jamesshao8/ymfc-mini-drone/README.md

# ymfc-mini-drone
mini-drone (hardware design and software modification), based on ymfc-32

For detailed info, please visit:
https://www.crowdsupply.com/shaos-gadget/ymfc-flight-controller-and-mini-drone
