jamesshao8/ymfc-mini-drone/hardware/BOM_mini_drone_cs_2021-04-14.csv

ID | Name | Designator | Footprint | Quantity | Manufacturer Part | Manufacturer | Supplier | Supplier Part | Price | LCSC Assembly
1 | 100nF | C1,C2,C3,C4,C5,C6,C15,C17,C18,C19,C20,C21,C22,C23,C24,C27 | C0603 | 16 | CC0603KRX7R9BB104 | YAGEO | LCSC | C14663 | 0.01875 | Yes
2 | 22pF | C13,C14 | C0603 | 2 | CL10C220JB8NNNC | SAMSUNG | LCSC | C1653 | 0.032714 | Yes
3 | 2.2nF | C16 | C0603 | 1 | 0603B222K500NT | FH | LCSC | C1604 | 0.029075 | Yes
4 | 22uF | C25,C26 | C0805 | 2 | CL21A226MAQNNNE | SAMSUNG | LCSC | C45783 | 0.192553 | Yes
5 | SS210 | D1 | SMA_L4.3-W2.6-LS5.2-RD | 1 | SS210 | MDD | LCSC | C14996 | 0.128505 | Yes
6 | HDR-M-2.54_1x2 | BAT,J1,LF,LR,RF,RR | HDR-M-2.54_1X2 | 6 |  |  | LCSC | C124375 | 0.14
7 | 19-217/BHC-ZL1M2RY/3T | LEDB | LED0603-R-RD | 1 | 19-217/BHC-ZL1M2RY/3T | EVERLIGHT | LCSC | C72041 | 0.088419 | Yes
8 | 19-217/GHC-YR1S2/3T | LEDG | LED0603-R-RD | 1 | 19-217/GHC-YR1S2/3T | EVERLIGHT | LCSC | C72043 | 0.142772 | Yes
9 | LSSAM12-V-T/R | OFF/ON | SW-SMD_LSSAM12-V-T/R | 1 | LSSAM12-V-T/R | Diptronics | LCSC | C495944 | 1.7
10 | HDR-M-2.54_1x3 | PPM,PWM1,PWM2,PWM3,PWM4 | HDR-M-2.54_1X3 | 5 |  |  | LCSC | C180248 | 1.15
11 | SI2302 | Q1,Q2,Q3,Q4 | SOT-23-3_L2.9-W1.3-P1.90-LS2.4-BR | 4 | SI2302 | Hottech | LCSC | C181087 | 0.137 | Yes
12 | 4.7K | R1,R2,R5,R6 | R0603 | 4 | 0603WAF4701T5E | UniOhm | LCSC | C23162 | 0.005826 | Yes
13 | 100 | R3,R4 | R0402 | 2 | 0402WGF1000TCE | UniOhm | LCSC | C25076 | 0.003333 | Yes
14 | 1K | R7,R10,R12,R13,R16 | R0402 | 5 | 0402WGF1001TCE | UniOhm | LCSC | C11702 | 0.004793 | Yes
15 | 10K | R8,R9,R11,R14,R15 | R0402 | 5 | 0402WGF1002TCE | UniOhm | LCSC | C25744 | 0.004183 | Yes
16 | TS-1187A-B-A-B | RST | SW-SMD_4P-L5.1-W5.1-P3.70-LS6.4 | 1 | TS-1187A-B-A-B | XKB Enterprise | LCSC | C318884 | 0.138421 | Yes
17 | HDR-M-2.54_1x4 | SER | HDR-M-2.54_1X4 | 1 |  |  | LCSC | C124378 | 0.143949
18 | STM32F103C8T6 | U1 | LQFP-48_L7.0-W7.0-P0.50-LS9.0-BL | 1 | STM32F103C8T6 | STMicroelectronics | LCSC | C8734 | 14.18 | Yes
19 | MPU-6050_C24112 | U2 | QFN-24_L4.0-W4.0-P0.50-BL-EP2.6 | 1 | MPU-6050 | InvenSense | LCSC | C24112 | 15.69 | Yes
20 | HT7533-1_C14289 | U3 | SOT-89-3_L4.5-W2.5-P1.50-LS4.2-BR | 1 | HT7533-1 | HOLTEK | LCSC | C14289 | 0.77914 | Yes
21 | 8MHz | X1 | OSC-SMD_L5.0-W3.2 | 1 | X50328MSB2GI | YXC | LCSC | C115962 | 1.58 | Yes
