jamesshao8/ymfc-mini-drone/(threads)

Thread 1 (2021-05-19):

Q&A

jamesshao8, 2021-05-19:
Hello backers,

Thanks for supporting this campaign. Should you have any question or difficulty in assembling the mini-drone, please leave a comment here. I will answer your questions so that other backers can take it as a reference.

KavinduZoysa, 2023-07-16:
Hello, What is the size of brushed DC motors used for mini drone?

KavinduZoysa, 2023-07-16:
> Hello, What is the size of brushed DC motors used for mini drone?

In the video, I found it as 8520. I just want to confirm it.

jamesshao8, 2023-07-17:
> > Hello, What is the size of brushed DC motors used for mini drone?
>
> In the video, I found it as 8520. I want to confirm it. Also, can you mention the size of the propellers?

Yes, the motors are 8520. Propeller is 75mm.

KavinduZoysa, 2023-07-17:
Can you provide some details of the mosfet used to control the brushed motors? I found it as `SI2302`, but there are several mosfet types that belong to this category.

jamesshao8, 2023-07-17:
> Can you provide some details of the mosfet used to control the brushed motors? I found it as `SI2302`, but there are several mosfet types that belong to this category.

I didn't use any special kind of mosfet. You can find enough information in the BOM.

FYI, I have pre-assembled product for comparison.
https://www.crowdsupply.com/shaos-gadget/ymfc-flight-controller-and-mini-drone

KavinduZoysa, 2023-07-17:
> BOM

From where can I found the BOM?

thurstinn, 2024-06-12:
I have everything setup up in both hardware and software as specified in this repo. My drone is running mini_main and when turning on the red led is eventually off indicating the setup was successful and there are no errors. Despite this when i try to throttle up the drone it immediately wants to pitch forward and/or left indicating that it is not leveling itself. Are there any pointers you can give me to help me get my drone to fly?

thurstinn, 2024-06-12:
I have verified that the propellers are correctly installed and have ran all the test code. The gyro/accelerometer are outputting data and responding to movement and the controller is functioning correctly. When the loop starts (start = 0) I am supposed to move the sticks to the top left to calibrate level correct? Also another question I have is that the code says to throttle low and yaw left to make start = to 1 and then while start = 1, throttle low and yaw right to make start = to 2 starting the motors and turning off the green led. But in practice I only move throttle low and yaw left to start the motors and the green led stays on. What am I missing and could this have anything to do with why its not working?

jamesshao8, 2024-06-12:
1. Yes, you can move both sticks to top left to calibrate level, but even if you do that, the drone will still drift a bit, because it doesn't have GPS to hold position. So it's normal that it wants to pitch forward when in the air, and you need to constantly adjust right stick.
2. throttle low, yaw left <-> start = 1. throttle low, yaw middle <-> start = 2, and motor spin. throttle low, yaw right <-> start = 0, and motor stop.
3. Yes, you won't see green led turning off in practice. Because when start becomes 2, next time entering into the loop, it will always execute green_led(HIGH) at line 200. I know it's a bit controverse with line 249, but we don't have too much LEDs to indicate different status.- The code at line 200 is trying to indicate flight mode. You can remove that, since mini-drone only have one flight mode.
4. For flight controller setting, you need set pitch (channel 2) in reverse direction as indicated in my video series. If not, the drone would go forward when you are controlling backward, and it can be found out with mini_test firmware.

jamesshao8, 2024-06-12:
> I have verified that the propellers are correctly installed and have ran all the test code. The gyro/accelerometer are outputting data and responding to movement and the controller is functioning correctly. When the loop starts (start = 0) I am supposed to move the sticks to the top left to calibrate level correct? Also another question I have is that the code says to throttle low and yaw left to make start = to 1 and then while start = 1, throttle low and yaw right to make start = to 2 starting the motors and turning off the green led. But in practice I only move throttle low and yaw left to start the motors and the green led stays on. What am I missing and could this have anything to do with why its not working? Also are there any other settings beside default that I should be applying to my remote controller ( I am using the FS-i6X)? I appreciate your help.

1. Yes, you can move both sticks to top left to calibrate level, but even if you do that, the drone will still drift a bit, because it doesn't have GPS to hold position. So it's normal that it wants to pitch forward when in the air, and you need to constantly adjust right stick.
2. throttle low, yaw left <-> start = 1. throttle low, yaw middle <-> start = 2, and motor spin. throttle low, yaw right <-> start = 0, and motor stop.
3. Yes, you won't see green led turning off in practice. Because when start becomes 2, next time entering into the loop, it will always execute green_led(HIGH) at line 200. I know it's a bit controverse with line 249, but we don't have too much LEDs to indicate different status.- The code at line 200 is trying to indicate flight mode. You can remove that, since mini-drone only have one flight mode.
4. For flight controller setting, you need set pitch (channel 2) in reverse direction as indicated in my video series. If not, the drone would go forward when you are controlling backward, and it can be found out with mini_test firmware.

thurstinn, 2024-06-13:
Thanks for your help. I found out that my gyro is rotated 90 degrees from where it is supposed to be so I just changed which side was going to be front and moved the motors accordingly and now I am having better success at getting it off the ground.
