jamesshao8/ymfc-mini-drone/hardware/Schematic_mini_drone_cs_2021-04-14.pdf

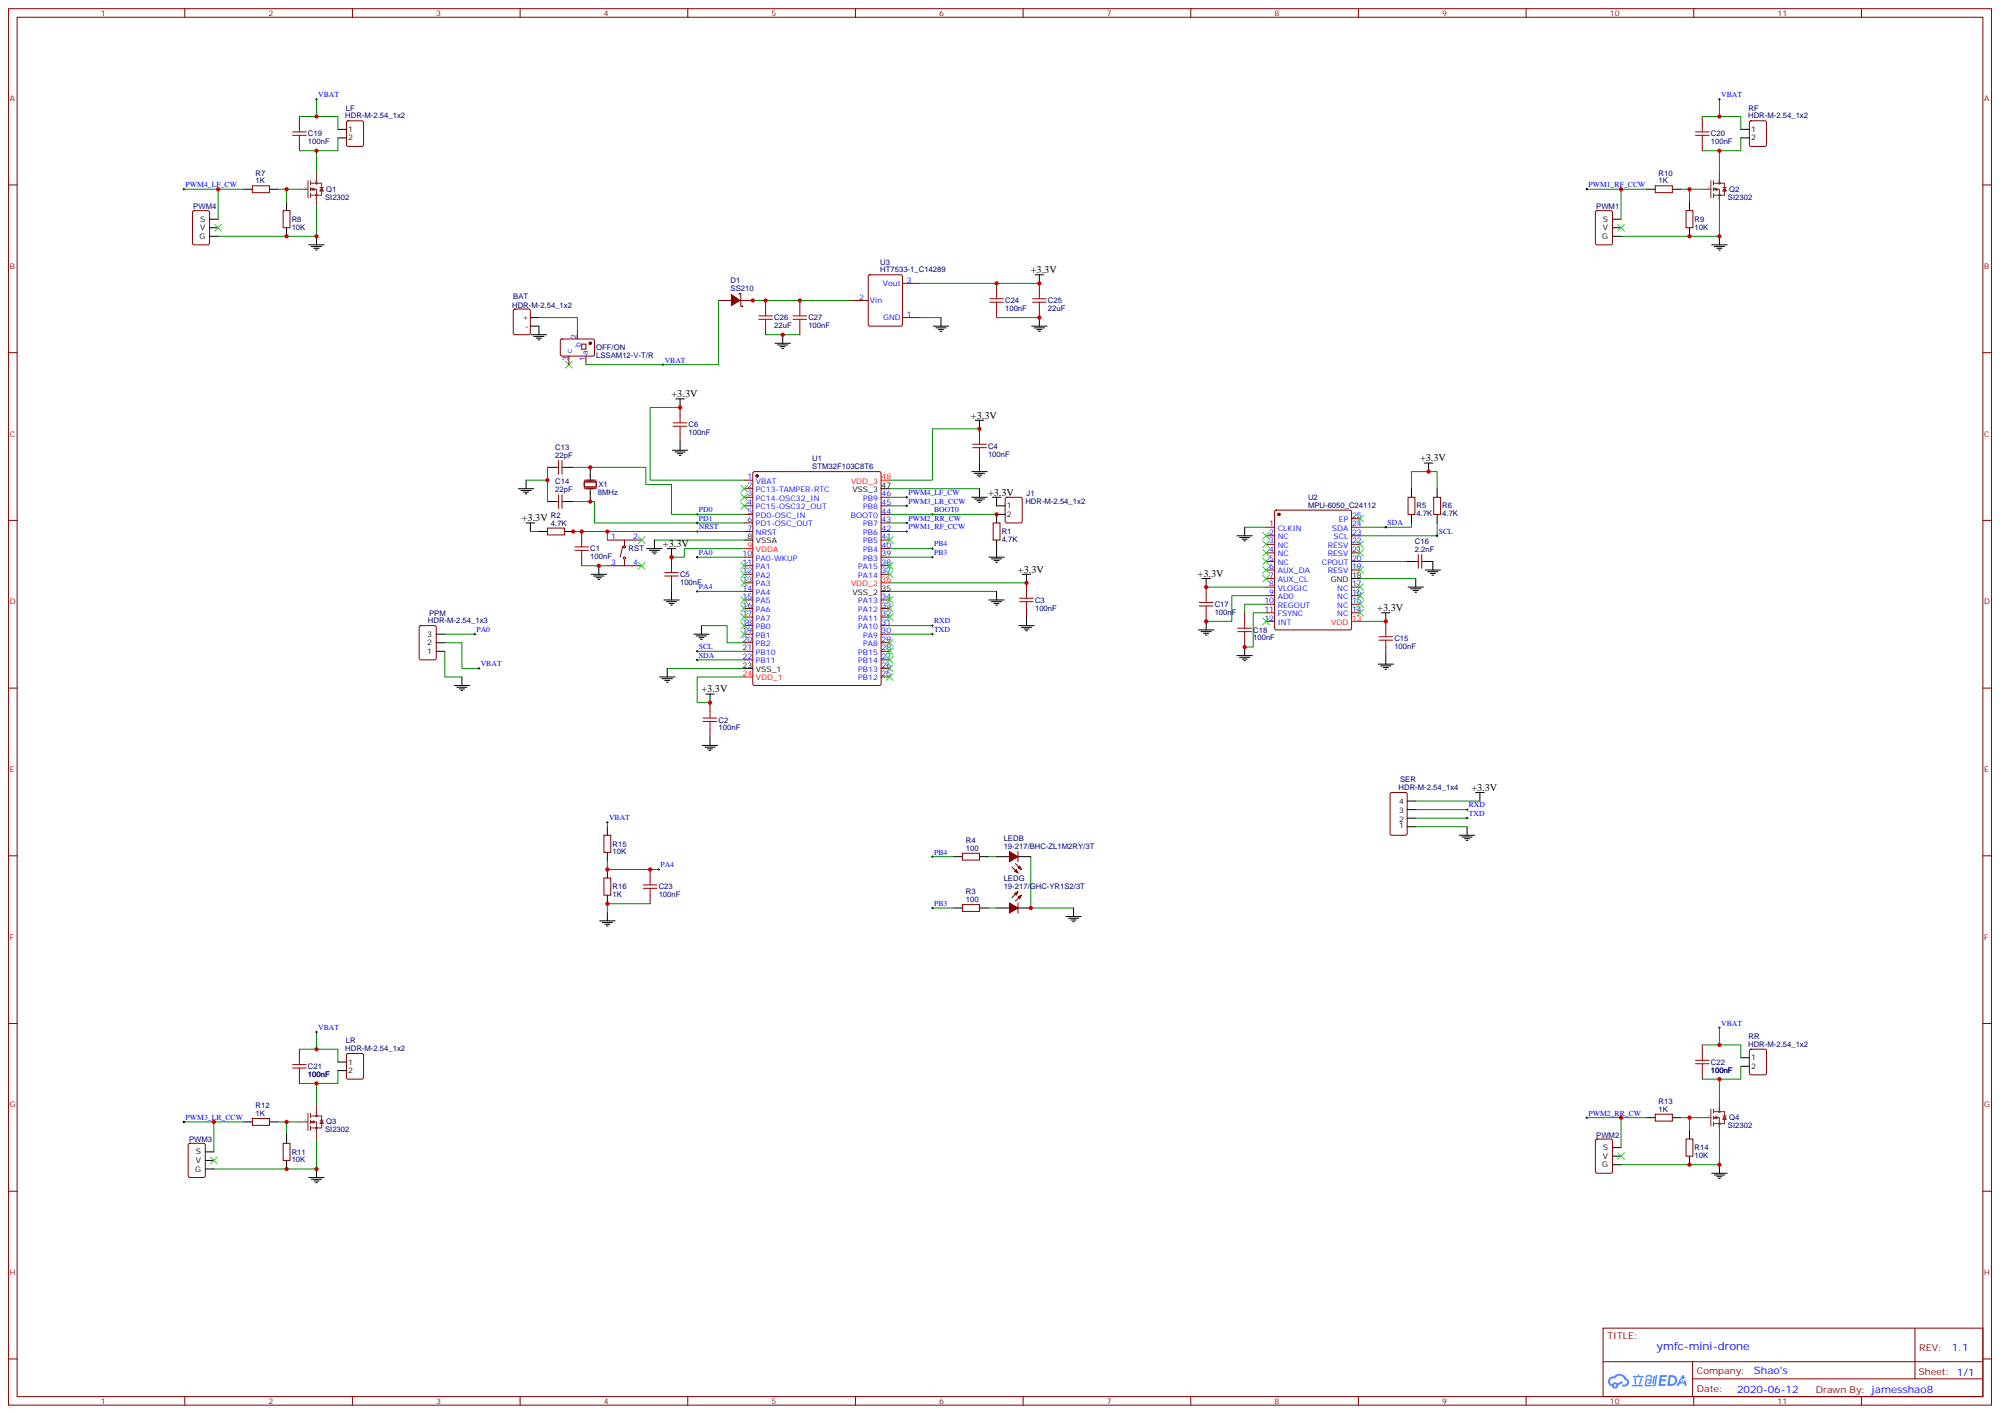
[picture p1: page 1]
