jamesshao8/ymfc-mini-drone/fc/flight_controller_main/flight_controller_main.ino

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
#include <EEPROM.h>
#include <Wire.h>                          //Include the Wire.h library so we can communicate with the gyro.
TwoWire HWire (2, I2C_FAST_MODE);          //Initiate I2C port 2 at 400kHz.

///////////////////////////////////////////////////////////////////////////////////////////////////////////////////////////////////////
//PID gain and limit settings
///////////////////////////////////////////////////////////////////////////////////////////////////////////////////////////////////////
float pid_p_gain_roll = 1.3;               //Gain setting for the pitch and roll P-controller (default = 1.3).
float pid_i_gain_roll = 0.04;              //Gain setting for the pitch and roll I-controller (default = 0.04).
float pid_d_gain_roll = 18.0;              //Gain setting for the pitch and roll D-controller (default = 18.0).
int pid_max_roll = 400;                    //Maximum output of the PID-controller (+/-).

float pid_p_gain_pitch = pid_p_gain_roll;  //Gain setting for the pitch P-controller.
float pid_i_gain_pitch = pid_i_gain_roll;  //Gain setting for the pitch I-controller.
float pid_d_gain_pitch = pid_d_gain_roll;  //Gain setting for the pitch D-controller.
int pid_max_pitch = pid_max_roll;          //Maximum output of the PID-controller (+/-).

float pid_p_gain_yaw = 4.0;                //Gain setting for the pitch P-controller (default = 4.0).
float pid_i_gain_yaw = 0.02;               //Gain setting for the pitch I-controller (default = 0.02).
float pid_d_gain_yaw = 0.0;                //Gain setting for the pitch D-controller (default = 0.0).
int pid_max_yaw = 400;                     //Maximum output of the PID-controller (+/-).

//During flight the battery voltage drops and the motors are spinning at a lower RPM. This has a negative effecct on the
//altitude hold function. With the battery_compensation variable it's possible to compensate for the battery voltage drop.
//Increase this value when the quadcopter drops due to a lower battery voltage during a non altitude hold flight.
float battery_compensation = 40.0;

int16_t manual_takeoff_throttle = 1505;    //Enter the manual hover point when auto take-off detection is not desired (between 1400 and 1600).
int16_t motor_idle_speed = 1100;           //Enter the minimum throttle pulse of the motors when they idle (between 1000 and 1200). 1170 for DJI

uint8_t gyro_address = 0x68;               //The I2C address of the MPU-6050 is 0x68 in hexadecimal form.

float battery_voltage_calibration = 0.0;   //Battery voltage offset calibration.
float low_battery_warning = 3.4;          //Set the battery warning at 10.5V (default = 10.5V).

///////////////////////////////////////////////////////////////////////////////////////////////////////////////////////////////////////
//Declaring global variables
///////////////////////////////////////////////////////////////////////////////////////////////////////////////////////////////////////
//int16_t = signed 16 bit integer
//uint16_t = unsigned 16 bit integer

uint8_t last_channel_1, last_channel_2, last_channel_3, last_channel_4;
uint8_t check_byte, flip32, start;
uint8_t error, error_counter, error_led;
uint8_t flight_mode, flight_mode_counter, flight_mode_led;
uint8_t takeoff_detected, manual_altitude_change;
uint8_t channel_select_counter;
uint8_t level_calibration_on;

int16_t esc_1, esc_2, esc_3, esc_4;
int16_t manual_throttle;
int16_t throttle, takeoff_throttle, cal_int;
int16_t temperature, count_var;
int16_t acc_x, acc_y, acc_z;
int16_t gyro_pitch, gyro_roll, gyro_yaw;

int32_t channel_1_start, channel_1;
int32_t channel_2_start, channel_2;
int32_t channel_3_start, channel_3;
int32_t channel_4_start, channel_4;
int32_t channel_5_start, channel_5;
int32_t channel_6_start, channel_6;
int32_t measured_time, measured_time_start, receiver_watchdog;
int32_t acc_total_vector, acc_total_vector_at_start;
int32_t gyro_roll_cal, gyro_pitch_cal, gyro_yaw_cal;
int16_t acc_pitch_cal_value;
int16_t acc_roll_cal_value;

uint32_t loop_timer, error_timer, flight_mode_timer;
uint32_t delay_micros_timer;

float roll_level_adjust, pitch_level_adjust;
float pid_error_temp;
float pid_i_mem_roll, pid_roll_setpoint, gyro_roll_input, pid_output_roll, pid_last_roll_d_error;
float pid_i_mem_pitch, pid_pitch_setpoint, gyro_pitch_input, pid_output_pitch, pid_last_pitch_d_error;
float pid_i_mem_yaw, pid_yaw_setpoint, gyro_yaw_input, pid_output_yaw, pid_last_yaw_d_error;
float angle_roll_acc, angle_pitch_acc, angle_pitch, angle_roll, angle_yaw;
float battery_voltage, dummy_float;

///////////////////////////////////////////////////////////////////////////////////////////////////////////////////////////////////////
//Setup routine
///////////////////////////////////////////////////////////////////////////////////////////////////////////////////////////////////////
void setup() {
  pinMode(4, INPUT_ANALOG);                                     //This is needed for reading the analog value of port A4.
  //Port PB3 and PB4 are used as JTDO and JNTRST by default.
  //The following function connects PB3 and PB4 to the
  //alternate output function.
  afio_cfg_debug_ports(AFIO_DEBUG_SW_ONLY);                     //Connects PB3 and PB4 to output function.
  flip32 = 0;

  pinMode(PB3, OUTPUT);                                         //Set PB3 as output for green LED.
  pinMode(PB4, OUTPUT);                                         //Set PB4 as output for red LED.

  green_led(LOW);                                               //Set output PB3 low.
  red_led(HIGH);                                                //Set output PB4 high.

  pinMode(PB0, OUTPUT);                                         //Set PB0 as output for telemetry TX.

  //EEPROM emulation setup
  EEPROM.PageBase0 = 0x801F000;
  EEPROM.PageBase1 = 0x801F800;
  EEPROM.PageSize  = 0x400;

  //Serial.begin(57600);                                        //Set the serial output to 57600 kbps. (for debugging only)
  //delay(250);                                                 //Give the serial port some time to start to prevent data loss.

  timer_setup();                                                //Setup the timers for the receiver inputs and ESC's output.
  delay(50);                                                    //Give the timers some time to start.


  //Check if the MPU-6050 is responding.
  HWire.begin();                                                //Start the I2C as master
  HWire.beginTransmission(gyro_address);                        //Start communication with the MPU-6050.
  error = HWire.endTransmission();                              //End the transmission and register the exit status.
  while (error != 0) {                                          //Stay in this loop because the MPU-6050 did not responde.
    error = 1;                                                  //Set the error status to 1.
    error_signal();                                             //Show the error via the red LED.
    delay(4);                                                   //Simulate a 250Hz refresch rate as like the main loop.
  }

  gyro_setup();                                                 //Initiallize the gyro and set the correct registers.

  //Create a 5 second delay before calibration.
  for (count_var = 0; count_var < 1250; count_var++) {          //1250 loops of 4 microseconds = 5 seconds.
    if (count_var % 125 == 0) {                                 //Every 125 loops (500ms).
      digitalWrite(PB4, !digitalRead(PB4));                     //Change the led status.
    }
    delay(4);                                                   //Simulate a 250Hz refresch rate as like the main loop.
  }
  count_var = 0;                                                //Set start back to 0.
  calibrate_gyro();                                             //Calibrate the gyro offset.

  //Wait until the receiver is active.
  while (channel_1 < 990 || channel_2 < 990 || channel_3 < 990 || channel_4 < 990)  {
    error = 4;                                                  //Set the error status to 4.
    error_signal();                                             //Show the error via the red LED.
    delay(4);                                                   //Delay 4ms to simulate a 250Hz loop
  }
  error = 0;                                                    //Reset the error status to 0.


  //When everything is done, turn off the led.
  red_led(LOW);                                                 //Set output PB4 low.

  //Load the battery voltage to the battery_voltage variable.
  //The STM32 uses a 12 bit analog to digital converter.
  //analogRead => 0 = 0V ..... 4095 = 3.3V
  //The voltage divider (1k & 10k) is 1:11.
  //analogRead => 0 = 0V ..... 4095 = 36.3V
  //36.3 / 4095 = 112.81.
  //The variable battery_voltage holds 1050 if the battery voltage is 10.5V.
  battery_voltage = (float)analogRead(4) / 112.81;

  start = 0;

  if (motor_idle_speed < 1000)motor_idle_speed = 1000;          //Limit the minimum idle motor speed to 1000us.
  if (motor_idle_speed > 1200)motor_idle_speed = 1200;          //Limit the maximum idle motor speed to 1200us.

  loop_timer = micros();                                        //Set the timer for the first loop.
}
///////////////////////////////////////////////////////////////////////////////////////////////////////////////////////////////////////
//Main program loop
///////////////////////////////////////////////////////////////////////////////////////////////////////////////////////////////////////
void loop() {
  if (receiver_watchdog < 750)receiver_watchdog ++;
  if (receiver_watchdog == 750 && start == 2) {
    channel_1 = 1500;
    channel_2 = 1500;
    channel_3 = 1500;
    channel_4 = 1500;
    error = 8;
 
  }
  //Some functions are only accessible when the quadcopter is off.
  if (start == 0) {
   
    //Level calibration move both sticks to the top left.
    if (channel_1 < 1100 && channel_2 < 1100 && channel_3 > 1900 && channel_4 < 1100)calibrate_level();
  
  }

  flight_mode = 1;                                                                 //In all other situations the flight mode is 1;
  green_led(HIGH);     

  //Run some subroutines
  error_signal();                                                                  //Show the error via the red LED.
  gyro_signalen();                                                                 //Read the gyro and accelerometer data.

  //65.5 = 1 deg/sec (check the datasheet of the MPU-6050 for more information).
  gyro_roll_input = (gyro_roll_input * 0.7) + (((float)gyro_roll / 65.5) * 0.3);   //Gyro pid input is deg/sec.
  gyro_pitch_input = (gyro_pitch_input * 0.7) + (((float)gyro_pitch / 65.5) * 0.3);//Gyro pid input is deg/sec.
  gyro_yaw_input = (gyro_yaw_input * 0.7) + (((float)gyro_yaw / 65.5) * 0.3);      //Gyro pid input is deg/sec.


  ////////////////////////////////////////////////////////////////////////////////////////////////////
  //This is the added IMU code from the videos:
  //https://youtu.be/4BoIE8YQwM8
  //https://youtu.be/j-kE0AMEWy4
  ////////////////////////////////////////////////////////////////////////////////////////////////////

  //Gyro angle calculations
  //0.0000611 = 1 / (250Hz / 65.5)
  angle_pitch += (float)gyro_pitch * 0.0000611;                                    //Calculate the traveled pitch angle and add this to the angle_pitch variable.
  angle_roll += (float)gyro_roll * 0.0000611;                                      //Calculate the traveled roll angle and add this to the angle_roll variable.
 
  //0.000001066 = 0.0000611 * (3.142(PI) / 180degr) The Arduino sin function is in radians and not degrees.
  angle_pitch -= angle_roll * sin((float)gyro_yaw * 0.000001066);                  //If the IMU has yawed transfer the roll angle to the pitch angel.
  angle_roll += angle_pitch * sin((float)gyro_yaw * 0.000001066);                  //If the IMU has yawed transfer the pitch angle to the roll angel.

  //Accelerometer angle calculations
  acc_total_vector = sqrt((acc_x * acc_x) + (acc_y * acc_y) + (acc_z * acc_z));    //Calculate the total accelerometer vector.

  if (abs(acc_y) < acc_total_vector) {                                             //Prevent the asin function to produce a NaN.
    angle_pitch_acc = asin((float)acc_y / acc_total_vector) * 57.296;              //Calculate the pitch angle.
  }
  if (abs(acc_x) < acc_total_vector) {                                             //Prevent the asin function to produce a NaN.
    angle_roll_acc = asin((float)acc_x / acc_total_vector) * 57.296;               //Calculate the roll angle.
  }

  angle_pitch = angle_pitch * 0.9996 + angle_pitch_acc * 0.0004;                   //Correct the drift of the gyro pitch angle with the accelerometer pitch angle.
  angle_roll = angle_roll * 0.9996 + angle_roll_acc * 0.0004;                      //Correct the drift of the gyro roll angle with the accelerometer roll angle.

  pitch_level_adjust = angle_pitch * 15;                                           //Calculate the pitch angle correction.
  roll_level_adjust = angle_roll * 15;                                             //Calculate the roll angle correction.

  calculate_pid();                                                                 //Calculate the pid outputs based on the receiver inputs.
    if (channel_3 < 1050 && channel_4 < 1050) {
        start = 1;
    }
     if (start == 1 && channel_3 < 1050 && channel_4 > 1450) {
        start = 2;
        green_led(LOW);                                                    

        angle_pitch = angle_pitch_acc;                                        
        angle_roll = angle_roll_acc;                                          

        pid_i_mem_roll = 0;
        pid_last_roll_d_error = 0;
        pid_i_mem_pitch = 0;
        pid_last_pitch_d_error = 0;
        pid_i_mem_yaw = 0;
        pid_last_yaw_d_error = 0;
    }
    //Stopping the motors: throttle low and yaw right.
    if (start == 2 && channel_3 < 1050 &&  channel_4 > 1950) {
        start = 0;
        green_led(HIGH);                                                      
    }

  //The battery voltage is needed for compensation.
  //A complementary filter is used to reduce noise.
  battery_voltage = (battery_voltage * 0.92) + ((((float)analogRead(4) / 112.81) + battery_voltage_calibration) * 0.08);

  //Turn on the led if battery voltage is to low. Default setting is 3.5V
  if (battery_voltage > 3.3 && battery_voltage < low_battery_warning && error == 0)error = 1;

  throttle = channel_3;

  ////////////////////////////////////////////////////////////////////////////////////////////////////
  //Creating the pulses for the ESC's is explained in this video:
  //https://youtu.be/Nju9rvZOjVQ
  ////////////////////////////////////////////////////////////////////////////////////////////////////

  if (start == 2) {                                                                //The motors are started.
    if (throttle > 1800) throttle = 1800;                                          //We need some room to keep full control at full throttle.
    esc_1 = throttle - pid_output_pitch + pid_output_roll - pid_output_yaw;        //Calculate the pulse for esc 1 (front-right - CCW).
    esc_2 = throttle + pid_output_pitch + pid_output_roll + pid_output_yaw;        //Calculate the pulse for esc 2 (rear-right - CW).
    esc_3 = throttle + pid_output_pitch - pid_output_roll - pid_output_yaw;        //Calculate the pulse for esc 3 (rear-left - CCW).
    esc_4 = throttle - pid_output_pitch - pid_output_roll + pid_output_yaw;        //Calculate the pulse for esc 4 (front-left - CW).

    if (battery_voltage < 3.60 && battery_voltage > 3.4) {                        //Is the battery connected?
      esc_1 += (3.60 - battery_voltage) * battery_compensation;                   //Compensate the esc-1 pulse for voltage drop.
      esc_2 += (3.60 - battery_voltage) * battery_compensation;                   //Compensate the esc-2 pulse for voltage drop.
      esc_3 += (3.60 - battery_voltage) * battery_compensation;                   //Compensate the esc-3 pulse for voltage drop.
      esc_4 += (3.60 - battery_voltage) * battery_compensation;                   //Compensate the esc-4 pulse for voltage drop.
    }

    if (esc_1 < motor_idle_speed) esc_1 = motor_idle_speed;                        //Keep the motors running.
    if (esc_2 < motor_idle_speed) esc_2 = motor_idle_speed;                        //Keep the motors running.
    if (esc_3 < motor_idle_speed) esc_3 = motor_idle_speed;                        //Keep the motors running.
    if (esc_4 < motor_idle_speed) esc_4 = motor_idle_speed;                        //Keep the motors running.

    if (esc_1 > 2000)esc_1 = 2000;                                                 //Limit the esc-1 pulse to 2000us.
    if (esc_2 > 2000)esc_2 = 2000;                                                 //Limit the esc-2 pulse to 2000us.
    if (esc_3 > 2000)esc_3 = 2000;                                                 //Limit the esc-3 pulse to 2000us.
    if (esc_4 > 2000)esc_4 = 2000;                                                 //Limit the esc-4 pulse to 2000us.
  }

  else {
    esc_1 = 1000;                                                                  //If start is not 2 keep a 1000us pulse for ess-1.
    esc_2 = 1000;                                                                  //If start is not 2 keep a 1000us pulse for ess-2.
    esc_3 = 1000;                                                                  //If start is not 2 keep a 1000us pulse for ess-3.
    esc_4 = 1000;                                                                  //If start is not 2 keep a 1000us pulse for ess-4.
  }


  TIMER4_BASE->CCR1 = esc_1;                                                       //Set the throttle receiver input pulse to the ESC 1 output pulse.
  TIMER4_BASE->CCR2 = esc_2;                                                       //Set the throttle receiver input pulse to the ESC 2 output pulse.
  TIMER4_BASE->CCR3 = esc_3;                                                       //Set the throttle receiver input pulse to the ESC 3 output pulse.
  TIMER4_BASE->CCR4 = esc_4;                                                       //Set the throttle receiver input pulse to the ESC 4 output pulse.
  TIMER4_BASE->CNT = 5000;                                                         //This will reset timer 4 and the ESC pulses are directly created.


  //! ! ! ! ! ! ! ! ! ! ! ! ! ! ! ! ! ! ! ! ! ! ! ! ! ! ! ! ! ! ! ! ! ! ! ! ! ! ! ! ! ! ! ! ! ! ! ! ! !
  //Because of the angle calculation the loop time is getting very important. If the loop time is
  //longer or shorter than 4000us the angle calculation is off. If you modify the code make sure
  //that the loop time is still 4000us and no longer! More information can be found on
  //the Q&A page:
  //! ! ! ! ! ! ! ! ! ! ! ! ! ! ! ! ! ! ! ! ! ! ! ! ! ! ! ! ! ! ! ! ! ! ! ! ! ! ! ! ! ! ! ! ! ! ! ! ! !

  if (micros() - loop_timer > 4050)error = 2;                                      //Output an error if the loop time exceeds 4050us.
  while (micros() - loop_timer < 4000);                                            //We wait until 4000us are passed.
  loop_timer = micros();                                                           //Set the timer for the next loop.
}
