jamesshao8/ymfc-mini-drone/fc/flight_controller_main/LED_control.ino

///////////////////////////////////////////////////////////////////////////////////////////////////////////////////////////////////////
//These functions handle the red and green LEDs. The LEDs on the flip 32 are inverted. That is why a Flip32 test is needed.
///////////////////////////////////////////////////////////////////////////////////////////////////////////////////////////////////////
void red_led(int8_t level) {
  if (flip32)digitalWrite(PB4, !level);    //If a Flip32 is used invert the output.
  else digitalWrite(PB4, level);           //When using the BluePill the output should not be inverted.
}
void green_led(int8_t level) {
  if (flip32)digitalWrite(PB3, !level);    //If a Flip32 is used invert the output.
  else digitalWrite(PB3, level);           //When using the BluePill the output should not be inverted.
}

///////////////////////////////////////////////////////////////////////////////////////////////////////////////////////////////////////
//In this part the error LED signal is generated.
///////////////////////////////////////////////////////////////////////////////////////////////////////////////////////////////////////
void error_signal(void) {
  if (error >= 100) red_led(HIGH);                                                         //When the error is 100 the LED is always on.
  else if (error_timer < millis()) {                                                       //If the error_timer value is smaller that the millis() function.
    error_timer = millis() + 250;                                                          //Set the next error_timer interval at 250ms.
    if (error > 0 && error_counter > error + 3) error_counter = 0;                         //If there is an error to report and the error_counter > error +3 reset the error.
    if (error_counter < error && error_led == 0 && error > 0) {                            //If the error flash sequence isn't finisched (error_counter < error) and the LED is off.
      red_led(HIGH);                                                                       //Turn the LED on.
      error_led = 1;                                                                       //Set the LED flag to indicate that the LED is on.
    }
    else {                                                                                 //If the error flash sequence isn't finisched (error_counter < error) and the LED is on.
      red_led(LOW);                                                                        //Turn the LED off.
      error_counter++;                                                                     //Increment the error_counter variable by 1 to keep trach of the flashes.
      error_led = 0;                                                                       //Set the LED flag to indicate that the LED is off.
    }
  }
}
