jamesshao8/ymfc-mini-drone/fc/flight_controller_main/calibration.ino

///////////////////////////////////////////////////////////////////////////////////////////////////////////////////////////////////////
//In this part the level calibration procedres are handled.
///////////////////////////////////////////////////////////////////////////////////////////////////////////////////////////////////////

void calibrate_level(void) {
  level_calibration_on = 1;

  while (channel_2 < 1100) {
    delay(10);
  }
  red_led(HIGH);
  green_led(LOW);

  acc_pitch_cal_value = 0;
  acc_roll_cal_value = 0;

  for (error = 0; error < 64; error ++) {
    gyro_signalen();
    acc_pitch_cal_value += acc_y;
    acc_roll_cal_value += acc_x;
    if (acc_y > 500 || acc_y < -500)error = 80;
    if (acc_x > 500 || acc_x < -500)error = 80;
    delayMicroseconds(3700);
  }

  acc_pitch_cal_value /= 64;
  acc_roll_cal_value /= 64;

  red_led(LOW);
  if (error < 80) {
    EEPROM.write(0x16, acc_pitch_cal_value);
    EEPROM.write(0x17, acc_roll_cal_value);
    //EEPROM.write(0x10 + error, compass_cal_values[error]);
    for (error = 0; error < 15; error ++) {
      green_led(HIGH);
      delay(50);
      green_led(LOW);
      delay(50);
    }
    error = 0;
  }
  else error = 3;
  level_calibration_on = 0;
  gyro_signalen();
  //Accelerometer angle calculations
  acc_total_vector = sqrt((acc_x * acc_x) + (acc_y * acc_y) + (acc_z * acc_z));    //Calculate the total accelerometer vector.

  if (abs(acc_y) < acc_total_vector) {                                             //Prevent the asin function to produce a NaN.
    angle_pitch_acc = asin((float)acc_y / acc_total_vector) * 57.296;              //Calculate the pitch angle.
  }
  if (abs(acc_x) < acc_total_vector) {                                             //Prevent the asin function to produce a NaN.
    angle_roll_acc = asin((float)acc_x / acc_total_vector) * 57.296;               //Calculate the roll angle.
  }
  angle_pitch = angle_pitch_acc;                                                   //Set the gyro pitch angle equal to the accelerometer pitch angle when the quadcopter is started.
  angle_roll = angle_roll_acc;
  loop_timer = micros();                                                           //Set the timer for the next loop.
}
