jamesshao8/ymfc-mini-drone/(commit log)

2020-10-06 uploaded the code for brushless drone and battery measurement
2021-04-14 updated fabrication files
    [BOM_mini_drone_cs_2021-04-14.csv, PickAndPlace_mini_drone_cs_2021-04-14.csv]
